catphish/cable-lock/Hardware/HRO_TYPE-C-31-M-12.step

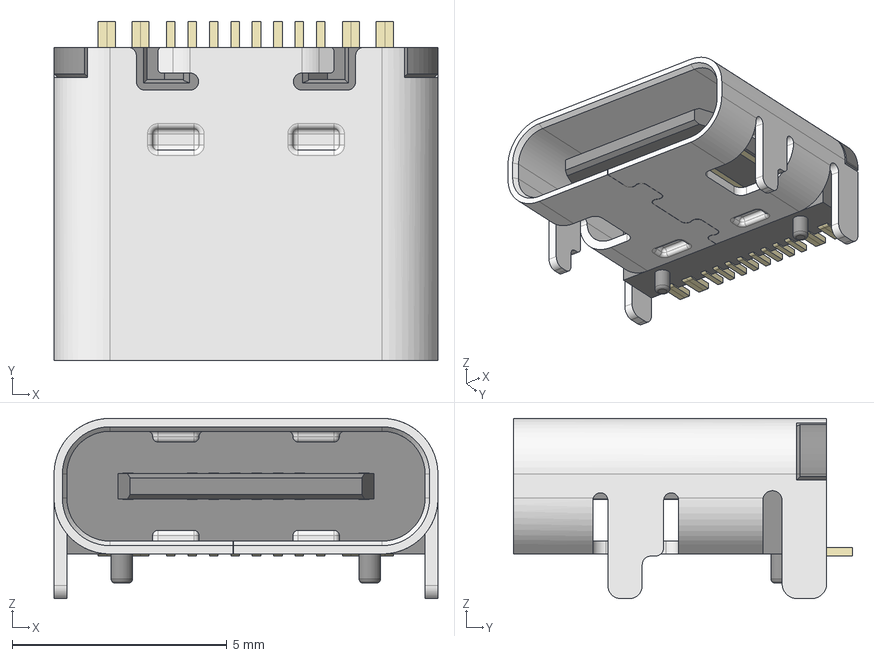
[picture p1: CAD file, 2026-04-29]
Hardware/HRO_TYPE-C-31-M-12.step
8.95 x 7.90 x 4.20 mm
