catphish/cable-lock/Hardware/KF128-2.54-10P.step

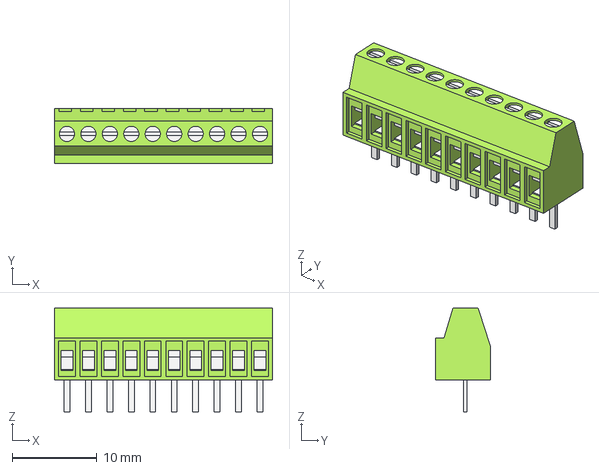
[picture p2: CAD file, 2026-04-29]
Hardware/KF128-2.54-10P.step
25.8 x 6.50 x 12.3 mm
Housing
PlasticBody
