catphish/cable-lock/Hardware/cable-lock.kicad_pcb

## KiCad design Hardware/cable-lock.kicad_pcb (2026-04-29)

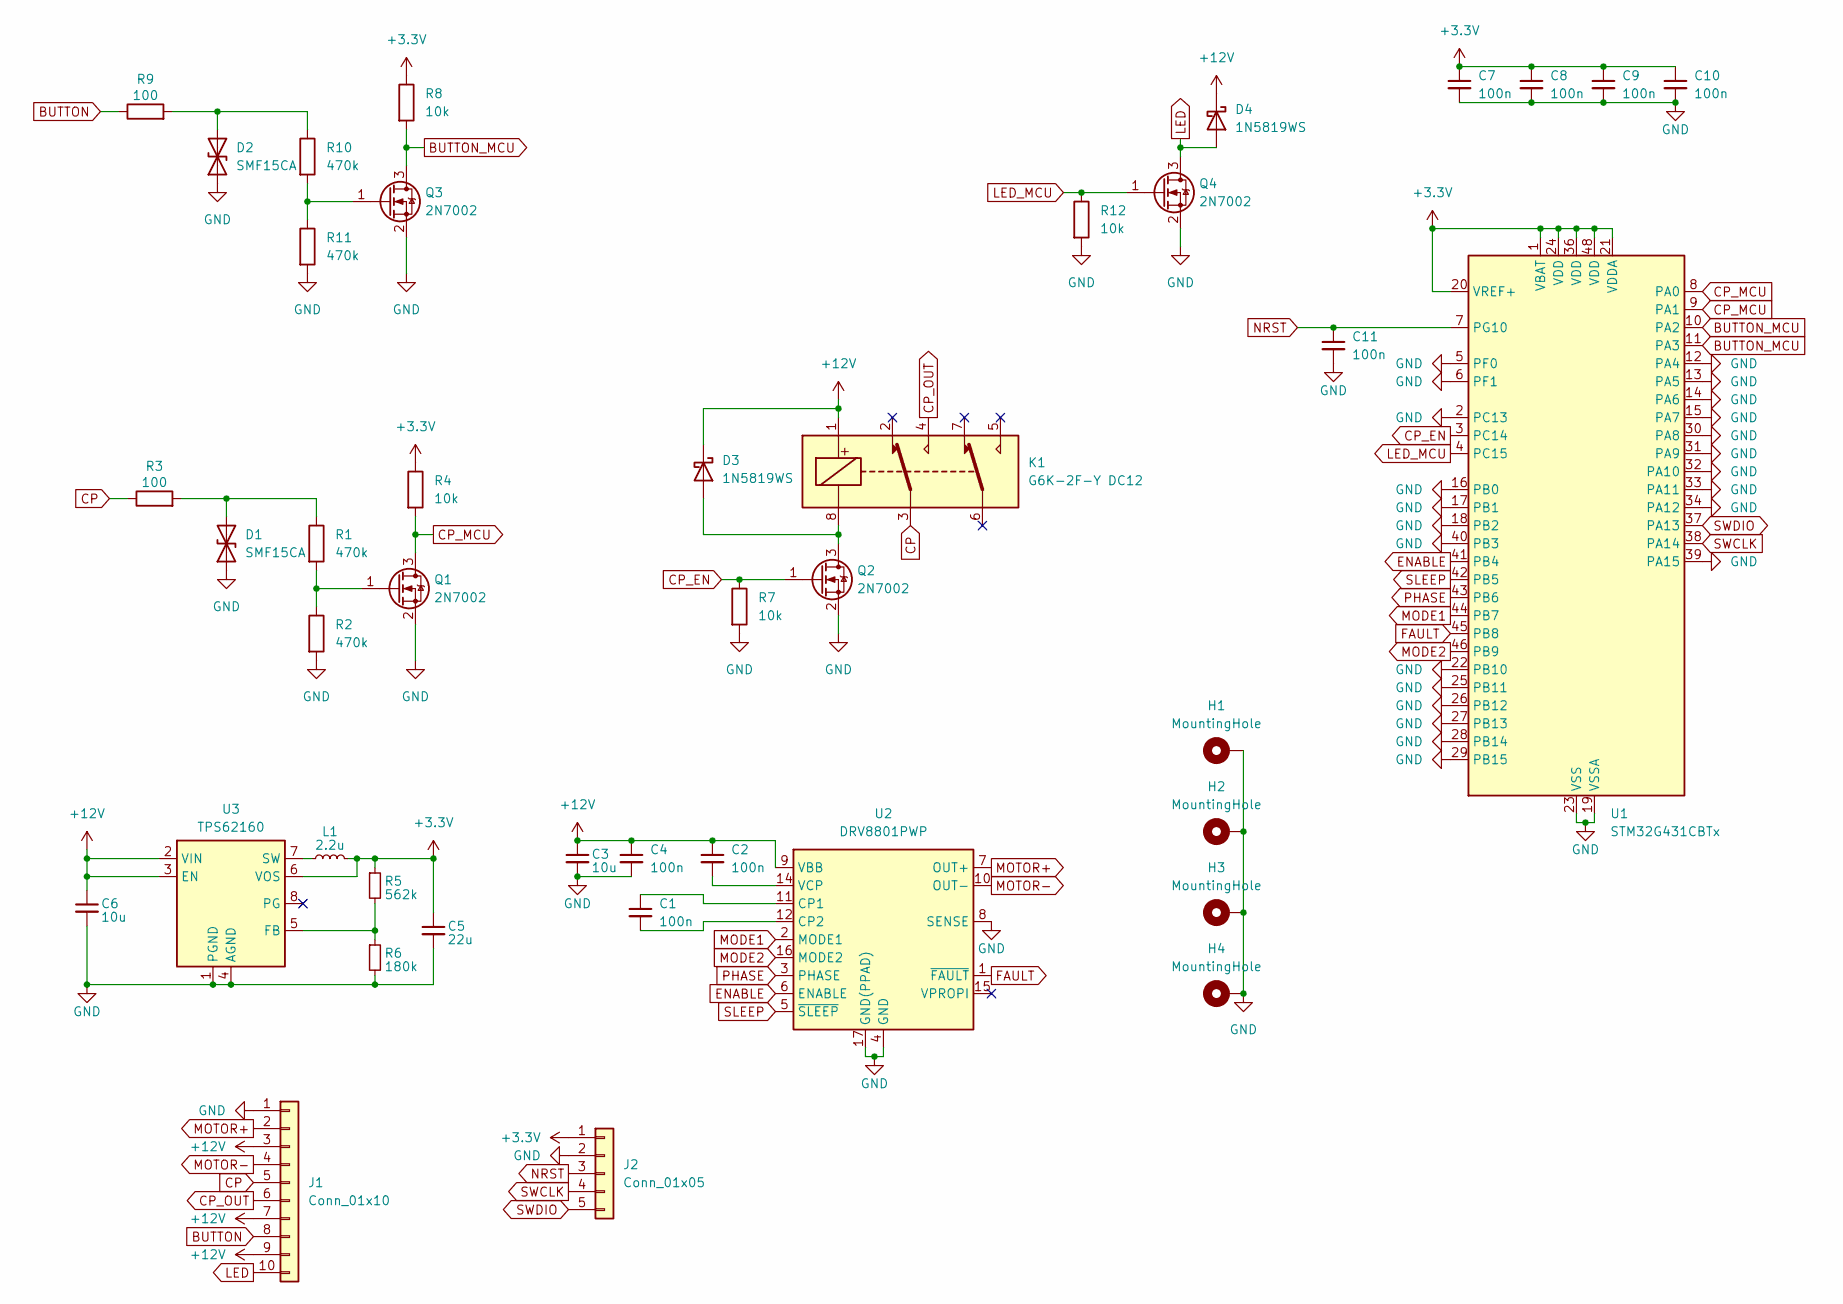
[picture p3: schematic cable-lock.kicad_sch]

Parts:
C1, C2, C4, C7, C8, C9, C10, C11: 100n; C_0402_1005Metric; LCSC C1525
C3, C6: 10u; C_1206_3216Metric; LCSC C13585
C5: 22u; C_1206_3216Metric; LCSC C5672
D1, D2: SMF15CA; D_SOD-123F; LCSC C19077510
D3, D4: 1N5819WS; D_SOD-323; LCSC C191023
H1, H2, H3, H4: MountingHole; MountingHole_2.2mm_M2_Pad
J1: Conn_01x10; TerminalBlock_TE_1-282834-0_1x10_P2.54mm_Horizontal; LCSC C918128
J2: Conn_01x05; PinHeader_1x05_P2.54mm_Vertical; LCSC C492404
K1: G6K-2F-Y DC12; Relay_DPDT_Omron_G6K-2F-Y; LCSC C397194
L1: 2.2u; L_Sunlord_SWPA3015S; LCSC C43389
Q1, Q2, Q3, Q4: 2N7002; SOT-23; LCSC C8545
R1, R2, R10, R11: 470k; R_0402_1005Metric; LCSC C25790
R3, R9: 100; R_0402_1005Metric; LCSC C25076
R4, R7, R8, R12: 10k; R_0402_1005Metric; LCSC C25744
R5: 562k; R_0402_1005Metric; LCSC C173826
R6: 180k; R_0402_1005Metric; LCSC C138046
U1: STM32G431CBTx; LQFP-48_7x7mm_P0.5mm; LCSC C529355
U2: DRV8801PWP; HTSSOP-16-1EP_4.4x5mm_P0.65mm_EP3.4x5mm_Mask3x3mm_ThermalVi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; LCSC C41146
U3: TPS62160; MSOP-8_3x3mm_P0.65mm; LCSC C60726

Connections:
+3.3V: C5.1, C7.1, C8.1, C9.1, C10.1, J2.1, L1.2, R4.1, R5.1, R8.1, U1.1 (VBAT), U1.20 (VREF+), U1.21 (VDDA), U1.24 (VDD), U1.36 (VDD), U1.48 (VDD), U3.6 (VOS)
+12V: C2.1, C3.1, C4.1, C6.1, D3.1 (K), D4.1 (K), J1.3, J1.7, J1.9, K1.1, U2.9 (VBB), U3.2 (VIN), U3.3 (EN)
BUTTON: J1.8, R9.1
BUTTON_MCU: Q3.3 (D), R8.2, U1.10 (PA2), U1.11 (PA3)
CP: J1.5, K1.3, R3.1
CP_EN: Q2.1 (G), R7.1, U1.3 (PC14)
CP_MCU: Q1.3 (D), R4.2, U1.8 (PA0), U1.9 (PA1)
CP_OUT: J1.6, K1.4
ENABLE: U1.41 (PB4), U2.6 (ENABLE)
FAULT: U1.45 (PB8), U2.1 (~FAULT)
GND: C3.2, C4.2, C5.2, C6.2, C7.2, C8.2, C9.2, C10.2, C11.2, D1.1 (A1), D2.1 (A1), H1.1, H2.1, H3.1, H4.1, J1.1, J2.2, Q1.2 (S), Q2.2 (S), Q3.2 (S), Q4.2 (S), R2.2, R6.2, R7.2, R11.2, R12.2, U1.2 (PC13), U1.5 (PF0), U1.6 (PF1), U1.12 (PA4), U1.13 (PA5), U1.14 (PA6), U1.15 (PA7), U1.16 (PB0), U1.17 (PB1), U1.18 (PB2), U1.19 (VSSA), U1.22 (PB10), U1.23 (VSS), U1.25 (PB11), U1.26 (PB12), U1.27 (PB13), U1.28 (PB14), U1.29 (PB15), U1.30 (PA8), U1.31 (PA9), U1.32 (PA10), U1.33 (PA11), U1.34 (PA12), U1.35 (VSS), U1.39 (PA15), U1.40 (PB3), U1.47 (VSS), U2.4 (GND), U2.8 (SENSE), U2.13 (GND), U2.17 (GND(PPAD)), U3.1 (PGND), U3.4 (AGND)
LED: D4.2 (A), J1.10, Q4.3 (D)
LED_MCU: Q4.1 (G), R12.1, U1.4 (PC15)
MODE1: U1.44 (PB7), U2.2 (MODE1)
MODE2: U1.46 (PB9), U2.16 (MODE2)
MOTOR+: J1.2, U2.7 (OUT+)
MOTOR-: J1.4, U2.10 (OUT-)
NRST: C11.1, J2.3, U1.7 (PG10)
unnamed: D1.2 (A2), R1.1, R3.2
unnamed: D2.2 (A2), R9.2, R10.1
unnamed: D3.2 (A), K1.8, Q2.3 (D)
unnamed: Q1.1 (G), R1.2, R2.1
unnamed: Q3.1 (G), R10.2, R11.1
unnamed: C1.1, U2.11 (CP1)
unnamed: C1.2, U2.12 (CP2)
unnamed: C2.2, U2.14 (VCP)
unnamed: R5.2, R6.1, U3.5 (FB)
unnamed: L1.1, U3.7 (SW)
PHASE: U1.43 (PB6), U2.3 (PHASE)
SLEEP: U1.42 (PB5), U2.5 (~SLEEP)
SWCLK: J2.4, U1.38 (PA14)
SWDIO: J2.5, U1.37 (PA13)

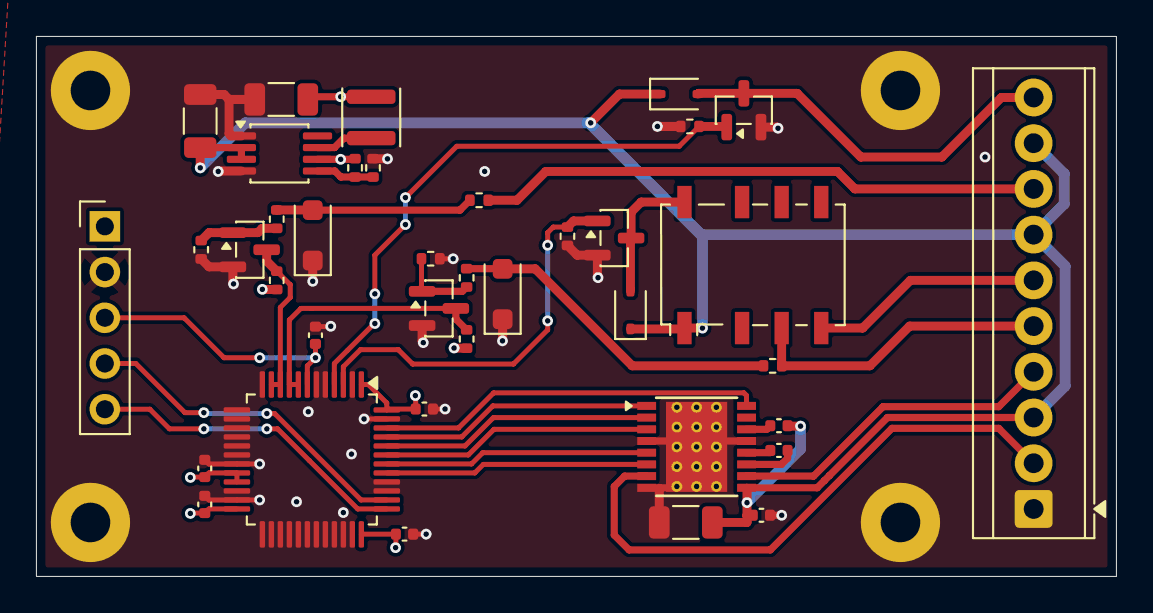
[picture p4: board cable-lock.kicad_pcb from above]

Board: 4 copper layers, 60.0 x 30.0 mm, 42 parts (0 on the bottom side), 32 nets.
