catphish/cable-lock/Firmware/cable-lock/Core/Inc/main.h

#define RELAY_Pin GPIO_PIN_14
#define RELAY_GPIO_Port GPIOC
#define LED_Pin GPIO_PIN_15
#define LED_GPIO_Port GPIOC
#define CP_WKUP_Pin GPIO_PIN_0
#define CP_WKUP_GPIO_Port GPIOA
#define CP_Pin GPIO_PIN_1
#define CP_GPIO_Port GPIOA
#define BUTTON_WKUP_Pin GPIO_PIN_2
#define BUTTON_WKUP_GPIO_Port GPIOA
#define BUTTON_Pin GPIO_PIN_3
#define BUTTON_GPIO_Port GPIOA
#define MOTOR_ENABLE_Pin GPIO_PIN_4
#define MOTOR_ENABLE_GPIO_Port GPIOB
#define MOTOR_SLEEP_Pin GPIO_PIN_5
#define MOTOR_SLEEP_GPIO_Port GPIOB
#define MOTOR_PHASE_Pin GPIO_PIN_6
#define MOTOR_PHASE_GPIO_Port GPIOB
#define MOTOR_MODE1_Pin GPIO_PIN_7
#define MOTOR_MODE1_GPIO_Port GPIOB
#define MOTOR_FAULT_Pin GPIO_PIN_8
#define MOTOR_FAULT_GPIO_Port GPIOB
#define MOTOR_MODE2_Pin GPIO_PIN_9
#define MOTOR_MODE2_GPIO_Port GPIOB
