catphish/cable-lock/(commit log)

2026-04-29 initial commit, v1 hardware order
    [HRO_TYPE-C-31-M-12.step, KF128-2.54-10P.step, cable-lock.kicad_pcb, cable-lock.kicad_sch]
2026-09-13 Add production files
    [bom.csv, designators.csv, positions.csv]
